GiorgosTriantafyllou324/Telemetry_SX1262_STM32/Telemetry_code/Core/Src/main.c

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
/* Includes ------------------------------------------------------------------*/
#include "main.h"
#include "usb_device.h"

/* USER CODE BEGIN Includes */
#include <SX1262.h>
#include <TeleMsgs_USB.h>
#include <TPMS.h>
#include "stm32f4xx_hal_gpio.h"
/* USER CODE END Includes */

/* USER CODE BEGIN PTD */

#define ADC_SAMPLES 1000

/* USER CODE END PTD */

/* USER CODE BEGIN PM */
MCU   mcu;
Radio radio;
TelemetryData_t teleData;
/* USER CODE END PM */

ADC_HandleTypeDef hadc1;
ADC_HandleTypeDef hadc2;
DMA_HandleTypeDef hdma_adc1;
DMA_HandleTypeDef hdma_adc2;

CAN_HandleTypeDef hcan1;
CAN_HandleTypeDef hcan2;

SPI_HandleTypeDef hspi1;

/* USER CODE BEGIN PV */

/* --------- ADC Variables BEGIN ----------- */
volatile uint16_t adc1results[3];
volatile uint32_t adc1_ch1_sum = 0,   adc1_ch2_sum = 0,   adc1_ch3_sum = 0;
volatile float    adc1_ch1_value = 0, adc1_ch2_value = 0, adc1_ch3_value = 0;
volatile uint16_t adc1_conv_cplt = 0;

volatile uint16_t adc2results[3];
volatile uint32_t adc2_ch12_sum = 0,   adc2_ch13_sum = 0,   adc2_ch15_sum = 0;
volatile float    adc2_ch12_value = 0, adc2_ch13_value = 0, adc2_ch15_value = 0;
volatile uint16_t adc2_conv_cplt = 0;

float linear_roll, linear_heave;
uint32_t last_linear_can_tx;
uint16_t linear_can_tx_interval = 90;
uint8_t  aero_fans_can_counter = 0;
/* --------- ADC Variables END ----------- */



/* -------- TPMS variables BEGIN --------- */
int8_t	 cal_sleep_time = 0;
int8_t 	 cal_wait_time  = 0;
bool 	 tpms_msg_sent = true;
int64_t  tpms_msg_time = 0;
uint32_t tpms_interval = 500;
uint32_t wait_time;
bool     config = false;
int8_t   tpms_power = 5;
uint16_t tpms_freq = 900;
TPMS_samplingFreq_t tx_freq;

// TPMS window variables
uint32_t current_tick;
int      window_start = 0;
uint16_t window_width = 120;
int64_t  delay        = 0;
int64_t  width_start  = 0;
int64_t  width_end    = 0;
/* --------- TPMS variables END ---------- */



/* -- Telemetry timing Variables BEGIN -- */
uint32_t rx_tick;
uint32_t tx_tick;
uint16_t tx_msg_delay = 20;  // --> 15ms
/* --- Telemetry timing Variables END --- */



/* ----- Telemetry Parameters BEGIN ----- */
uint8_t  tx_msg_id = 1;
int8_t   prev_dbm  = 22;
int8_t   curr_dbm  = 22;
uint16_t prev_freq = 900;
uint16_t curr_freq = 900;
/* ------ Telemetry Parameters END ------ */



/* --------- CAN-bus Variables BEGIN ----------- */
CAN_TxHeaderTypeDef TxHeader1;
CAN_RxHeaderTypeDef RxHeader1;
uint8_t TxData1[8];
uint8_t RxData1[8];

CAN_TxHeaderTypeDef TxHeader2;
CAN_RxHeaderTypeDef RxHeader2;
uint8_t TxData2[8];
uint8_t RxData2[8];

uint32_t TxMailbox;

uint16_t can1_msgs_rx = 0;
uint16_t can2_msgs_rx = 0;
/* ---------- CAN-bus Variables END ------------ */




/* USER CODE END PV */

void SystemClock_Config(void);
static void MX_GPIO_Init(void);
static void MX_DMA_Init(void);
static void MX_SPI1_Init(void);
static void MX_CAN1_Init(void);
static void MX_CAN2_Init(void);
static void MX_ADC1_Init(void);
static void MX_ADC2_Init(void);
/* USER CODE BEGIN PFP */
HAL_StatusTypeDef CanTxTPMSmessage(TelemetryData_t* teleData);
/* USER CODE END PFP */

/* USER CODE BEGIN 0 */

void HAL_GPIO_EXTI_Callback(uint16_t GPIO_Pin)
{
	if (GPIO_Pin == mcu.dio2.pin)
	{
		SX1262dio2Interrupt(&mcu, &radio);
	}

	else if (GPIO_Pin == mcu.dio1.pin)
	{
		radio.msg_pending = true;
	}
}

/* USER CODE END 0 */

/**
  * @brief  The application entry point.
  * @retval int
  */
int main(void)
{
  /* MCU Configuration--------------------------------------------------------*/

  /* Reset of all peripherals, Initializes the Flash interface and the Systick. */
  HAL_Init();

  /* Configure the system clock */
  SystemClock_Config();

  /* Initialize all configured peripherals */
  MX_GPIO_Init();
  MX_DMA_Init();
  MX_SPI1_Init();
  MX_CAN1_Init();
  MX_CAN2_Init();
  MX_ADC1_Init();
  MX_ADC2_Init();
  MX_USB_DEVICE_Init();
  /* USER CODE BEGIN 2 */
  /* MCU Configuration--------------------------------------------------------*/
  MCU_init(&mcu, &hspi1, GPIOA, NSS_Pin, GPIOB, NRESET_Pin, GPIOB,
		   BUSY_Pin, GPIOB, DIO1_Pin, GPIOB, DIO2_Pin, GPIOB, DIO3_Pin,
		   GPIOC, RF_SWITCH_Pin, GPIOC, RF_SWITCH_SUPP_Pin,
		   GPIOC, RADIO_TX_LED_Pin, GPIOD, RADIO_RX_LED_Pin,
		   GPIOA, CAN_TX_LED_Pin, GPIOC, CAN_RX_LED_Pin);

  /* TPMS Initializations */
  init_packet_types();
  TpmsStructsInit();
  radio.per.first_reception = true;

  /* Infinite loop */
  /* USER CODE BEGIN WHILE */


  SX1262GfskInit(&mcu, &radio, prev_dbm, prev_freq);
  //SX1262LoRaInit(&mcu, &radio, 22, 900);

  rx_tick = HAL_GetTick();


  HAL_ADC_Start_DMA(&hadc1, (uint32_t*)adc1results, 3);
  HAL_ADC_Start_DMA(&hadc2, (uint32_t*)adc2results, 3);

#if (FUNCTION == STNDBY)
	  SX1262SetFunction(&mcu, &radio, TPMS);
	  SX1262SetRxDutyCycle(&mcu, &radio, 200, 200);
#endif

  while (1)
  {
	if (radio.opMode != SLEEP_MODE)
		SX1262GetStatus(&mcu, &radio);


#if (FUNCTION == TELEMETRY_RX)
	{
		if (radio.opMode != RX_MODE)
			SX1262SetRxBoosted(&mcu, &radio, 0xFFFF);

		if (radio.msg_pending)
		{
			radio.rx_interval = HAL_GetTick() - rx_tick;
			rx_tick = HAL_GetTick();    // Used to calculate rx_interval

			SX1262dio1Interrupt(&mcu, &radio);
			SX1262GetStatus(&mcu, &radio);
			SX1262CalculatePacketLoss(&radio);
			SX1262ClearIrqStatus(&mcu, &radio, 0xFFFF);

			// Reset
			SX1262SetStandby(&mcu, &radio, STDBY_XOSC);
			SX1262SetRxBoosted(&mcu, &radio, 0xFFFF);

			process_rx_packet(&radio, &teleData);
			Transmit_USB(&radio, &teleData, radio.rx_msg[0]);


			radio.tele_rx_time = HAL_GetTick() - rx_tick;
			radio.msg_pending = false;
		}
	}
#endif

#if (FUNCTION == TELEMETRY_TX)

	if (HAL_GetTick() - tx_tick > tx_msg_delay)
	{
		radio.tx_interval = HAL_GetTick() - tx_tick;
		tx_tick = HAL_GetTick();

		CreateTeleTxMsg(&radio, tx_msg_id, &teleData);
		tx_msg_id++;
		if (tx_msg_id > PACKETS_NUM)
			tx_msg_id = 1;

		SX1262SendPayload(&mcu, &radio, radio.tx_msg, radio.packetParams.Params.Gfsk.PayloadLength - 2, 20, true);

		radio.tele_tx_time = HAL_GetTick() - tx_tick;
	}

	SX1262GetStatus(&mcu, &radio);
#endif

#if (FUNCTION == TELEMETRY_TPMS)
		if (tpms_msg_sent)  // TPMS sent message and a new time has to be decided
		{
			tpms_msg_time = HAL_GetTick() + tpms_interval;
			tpms_msg_sent = false;
		}

		if (HAL_GetTick() - tx_tick > tx_msg_delay)
		{
			radio.tx_interval = HAL_GetTick() - tx_tick;
			tx_tick = HAL_GetTick();

			/* TPMS Tx Message */
			SX1262SetFunction(&mcu, &radio, TPMS);

			if (config)
				SX1262CreateTpmsCfgrMsg(&radio, tpms_power, tpms_freq);
			else
			{
				wait_time = tpms_msg_time - HAL_GetTick() - 130; // -40
				switch (tpms_interval)
				{
				case (500):     /* 0.5s */
					 tx_freq = SAMPLE_0_5;
					 break;

				case (1000):     /* 1.0s */
					 tx_freq = SAMPLE_1_0;
					 break;

				case (3000):    /* 3.0s */
		             tx_freq = SAMPLE_3_0;
					 break;

				default:
					 break;
				}
				SX1262CreateTpmsRequestMsg(&radio, wait_time, tx_freq, cal_sleep_time, cal_wait_time);
			}

			SX1262SendPayload(&mcu, &radio, radio.tpms_tx_msg, radio.packetParams.Params.Gfsk.PayloadLength - 1, 5, true);
			radio.tpms_tx_time = HAL_GetTick() - tx_tick;

			/* Telemery Tx Message */
			tx_tick = HAL_GetTick();
			SX1262SetFunction(&mcu, &radio, TELEMETRY);

			CreateTeleTxMsg(&radio, tx_msg_id, &teleData);
			tx_msg_id++;
			if (tx_msg_id > PACKETS_NUM)
				tx_msg_id = 1;

			SX1262SendPayload(&mcu, &radio, radio.tx_msg, radio.packetParams.Params.Gfsk.PayloadLength - 2, 50, false);
			radio.tele_tx_time = HAL_GetTick() - tx_tick;
		}

		delay = (int64_t)(HAL_GetTick()) - tpms_msg_time;
		if (delay > window_start)  // 15 NORMALLY
		{
			radio.msg_pending = false;

			tpms_fr.not_received++;
			tpms_fl.not_received++;
			tpms_rr.not_received++;
			tpms_rl.not_received++;

			SX1262SetFunction(&mcu, &radio, TPMS);

//			tpms_msg_time = HAL_GetTick() + tpms_interval;

			SX1262SetRxBoosted(&mcu, &radio, 0xFFFF);
			tpms_msg_sent = true;
			current_tick = HAL_GetTick();
			width_start = HAL_GetTick() - tpms_msg_time;
			while (HAL_GetTick() - current_tick < window_width) // wait to get TPMS messages // 100 NORMALLY
			{
 				if (radio.msg_pending)
				{
 					radio.msg_pending = false;

					SX1262dio1Interrupt(&mcu, &radio);
					SX1262GetStatus(&mcu, &radio);
					SX1262ClearIrqStatus(&mcu, &radio, 0xFFFF);

					radio.tpms_variation = HAL_GetTick() - tpms_msg_time;

					TpmsGetMessage(&radio, &teleData);

					// Reset
					SX1262SetStandby(&mcu, &radio, STDBY_XOSC);
					SX1262SetRxBoosted(&mcu, &radio, 0xFFFF);
				}
			}
			width_end = HAL_GetTick() - tpms_msg_time;
			SX1262SetStandby(&mcu, &radio, STDBY_XOSC);

			CanTxTPMSmessage(&teleData);
		}
#endif

#if (FUNCTION == STANDBY)

		SX1262SetStandby(&mcu, &radio, STDBY_XOSC);
		//SX1262SetRxDutyCycle(&mcu, &radio, 200, 200);
		//SX1262GetStatus(&mcu, &radio);
#endif




	if ((prev_freq != curr_freq) || (prev_dbm != curr_dbm))
	{
		SX1262GfskInit(&mcu, &radio, curr_dbm, curr_freq);
		prev_freq = curr_freq;
		prev_dbm = curr_dbm;
	}


	if (HAL_GetTick() - last_linear_can_tx > linear_can_tx_interval)
	{
		last_linear_can_tx = HAL_GetTick();
		/* Sensory CAN BUS */
		TxHeader2.DLC = 4;
		TxHeader2.IDE = CAN_ID_STD;
		TxHeader2.RTR = CAN_RTR_DATA;
		TxHeader2.StdId = 0x4D2;
		TxHeader2.TransmitGlobalTime = DISABLE;
		TxData2[0] = (uint8_t)(linear_roll);
		TxData2[1] = (uint8_t)((linear_roll - TxData2[0]) * 100);
		TxData2[2] = (uint8_t)(linear_heave);
		TxData2[3] = (uint8_t)((linear_heave - TxData2[2]) * 100);
		HAL_CAN_AddTxMessage(&hcan2, &TxHeader2, TxData2, &TxMailbox);

		aero_fans_can_counter++;
		if (aero_fans_can_counter > 9)  // ~1s
		{
			TxHeader2.DLC = 1;
			TxHeader2.IDE = CAN_ID_STD;
			TxHeader2.RTR = CAN_RTR_DATA;
			TxHeader2.StdId = 0x313;
			TxHeader2.TransmitGlobalTime = DISABLE;

			/* Ensures that vicor which supplies the aero fans is not overtemp */
			TxData2[0] = teleData.dash.aero_fans_on && (!teleData.accu.vicor_overtemp);
			HAL_CAN_AddTxMessage(&hcan2, &TxHeader2, TxData2, &TxMailbox);

			aero_fans_can_counter = 0;
		}

	}

    /* USER CODE END WHILE */

    /* USER CODE BEGIN 3 */
  }

  /* USER CODE END 3 */
}

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
/* USER CODE BEGIN 4 */

/* Primary CAN */
void HAL_CAN_RxFifo0MsgPendingCallback(CAN_HandleTypeDef *hcan)
{
	if (hcan == &hcan1)
	{
		HAL_GPIO_WritePin(mcu.can_rx_led.type, mcu.can_rx_led.pin, GPIO_PIN_SET);

		HAL_CAN_GetRxMessage(&hcan1, CAN_RX_FIFO0, &RxHeader1, RxData1);
		can1_msgs_rx++;
		process_can1_rx_msg(&teleData, RxHeader1.StdId, RxData1);

		HAL_GPIO_WritePin(mcu.can_rx_led.type, mcu.can_rx_led.pin, GPIO_PIN_RESET);
	}
}

/* Sensory CAN */
void HAL_CAN_RxFifo1MsgPendingCallback(CAN_HandleTypeDef *hcan)
{
	if (hcan == &hcan2)
	{
		HAL_GPIO_WritePin(mcu.can_rx_led.type, mcu.can_rx_led.pin, GPIO_PIN_SET);

		HAL_CAN_GetRxMessage(&hcan2, CAN_RX_FIFO1, &RxHeader2, RxData2);
		can2_msgs_rx++;
		process_can2_rx_msg(&teleData, RxHeader2.StdId, RxData2);

		HAL_GPIO_WritePin(mcu.can_rx_led.type, mcu.can_rx_led.pin, GPIO_PIN_RESET);
	}
}


void HAL_ADC_ConvCpltCallback(ADC_HandleTypeDef* hadc)
{
	if (hadc == &hadc1)
	{
		adc1_conv_cplt++;

		if (adc1_conv_cplt < ADC_SAMPLES)
		{
			adc1_ch1_sum += adc1results[0];
			adc1_ch2_sum += adc1results[1];
			adc1_ch3_sum += adc1results[2];
		}
		else
		{
			adc1_conv_cplt = 0;

			adc1_ch1_value = (float)(adc1_ch1_sum) / ADC_SAMPLES;
			adc1_ch2_value = (float)(adc1_ch2_sum) / ADC_SAMPLES;
			adc1_ch3_value = (float)(adc1_ch3_sum) / ADC_SAMPLES;

			linear_roll  = 74.8 - 75.0 * (adc1_ch1_value / 4096);


			adc1_ch1_sum = 0;
			adc1_ch2_sum = 0;
			adc1_ch3_sum = 0;
		}
	}

	else if (hadc == &hadc2)
	{
		adc2_conv_cplt++;

		if (adc2_conv_cplt < ADC_SAMPLES)
		{
			adc2_ch12_sum += adc2results[0];
			adc2_ch13_sum += adc2results[1];
			adc2_ch15_sum += adc2results[2];
		}
		else
		{
			adc2_conv_cplt = 0;

			adc2_ch12_value = (float)(adc2_ch12_sum) / ADC_SAMPLES;
			adc2_ch13_value = (float)(adc2_ch13_sum) / ADC_SAMPLES;
			adc2_ch15_value = (float)(adc2_ch15_sum) / ADC_SAMPLES;

			linear_heave = 74.8 - 75.0 * (adc2_ch15_value / 4096);

			adc2_ch12_sum = 0;
			adc2_ch13_sum = 0;
			adc2_ch15_sum = 0;
		}
	}
}



HAL_StatusTypeDef CanTxTPMSmessage(TelemetryData_t* teleData)
{
	HAL_StatusTypeDef result;

	TxHeader2.DLC = 8;
	TxHeader2.IDE = CAN_ID_STD;
	TxHeader2.RTR = CAN_RTR_DATA;
	TxHeader2.StdId = 0x4F2;
	TxHeader2.TransmitGlobalTime = DISABLE;
	TxData2[0] = teleData->tpms.fr_press >> 8;    /* Gives a resolution of 1mBar */
	TxData2[1] = teleData->tpms.fr_press;
	TxData2[2] = teleData->tpms.fl_press >> 8;
	TxData2[3] = teleData->tpms.fl_press;
	TxData2[4] = teleData->tpms.rr_press >> 8;
	TxData2[5] = teleData->tpms.rr_press;
	TxData2[6] = teleData->tpms.rl_press >> 8;
	TxData2[7] = teleData->tpms.rl_press;
	result = HAL_CAN_AddTxMessage(&hcan2, &TxHeader2, TxData2, &TxMailbox);
	if (result != HAL_OK)
		return result;


	TxHeader2.DLC = 8;
	TxHeader2.IDE = CAN_ID_STD;
	TxHeader2.RTR = CAN_RTR_DATA;
	TxHeader2.StdId = 0x4F3;
	TxHeader2.TransmitGlobalTime = DISABLE;
	TxData2[0] = teleData->tpms.fr_temp >> 8;
	TxData2[1] = teleData->tpms.fr_temp;
	TxData2[2] = teleData->tpms.fl_temp >> 8;
	TxData2[3] = teleData->tpms.fl_temp;
	TxData2[4] = teleData->tpms.rr_temp >> 8;
	TxData2[5] = teleData->tpms.rr_temp;
	TxData2[6] = teleData->tpms.rl_temp >> 8;
	TxData2[7] = teleData->tpms.rl_temp;
	result = HAL_CAN_AddTxMessage(&hcan2, &TxHeader2, TxData2, &TxMailbox);

	return result;
}


/* USER CODE END 4 */
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
