GiorgosTriantafyllou324/Telemetry_SX1262_STM32/Telemetry_code/Core/Inc/main.h

#define NSS_Pin GPIO_PIN_4
#define NSS_GPIO_Port GPIOA
#define SCK_Pin GPIO_PIN_5
#define SCK_GPIO_Port GPIOA
#define MISO_Pin GPIO_PIN_6
#define MISO_GPIO_Port GPIOA
#define MOSI_Pin GPIO_PIN_7
#define MOSI_GPIO_Port GPIOA
#define NRESET_Pin GPIO_PIN_0
#define NRESET_GPIO_Port GPIOB
#define BUSY_Pin GPIO_PIN_1
#define BUSY_GPIO_Port GPIOB
#define DIO1_Pin GPIO_PIN_2
#define DIO1_GPIO_Port GPIOB
#define DIO1_EXTI_IRQn EXTI2_IRQn
#define DIO2_Pin GPIO_PIN_10
#define DIO2_GPIO_Port GPIOB
#define DIO2_EXTI_IRQn EXTI15_10_IRQn
#define DIO3_Pin GPIO_PIN_15
#define DIO3_GPIO_Port GPIOB
#define RF_SWITCH_Pin GPIO_PIN_6
#define RF_SWITCH_GPIO_Port GPIOC
#define RF_SWITCH_SUPP_Pin GPIO_PIN_7
#define RF_SWITCH_SUPP_GPIO_Port GPIOC
#define CAN_RX_LED_Pin GPIO_PIN_9
#define CAN_RX_LED_GPIO_Port GPIOC
#define CAN_TX_LED_Pin GPIO_PIN_9
#define CAN_TX_LED_GPIO_Port GPIOA
#define RADIO_TX_LED_Pin GPIO_PIN_11
#define RADIO_TX_LED_GPIO_Port GPIOC
#define RADIO_RX_LED_Pin GPIO_PIN_2
#define RADIO_RX_LED_GPIO_Port GPIOD
