GiorgosTriantafyllou324/Telemetry_SX1262_STM32/(notices)

Notices in the files:
Telemetry_code/Core/Inc/main.h:
Copyright (c) 2023 STMicroelectronics.
All rights reserved.
This software is licensed under terms that can be found in the LICENSE file
